humanixtechlab/EyeLink-Wheelchair/docs/images/tx-glasses-front.jpg.jpg

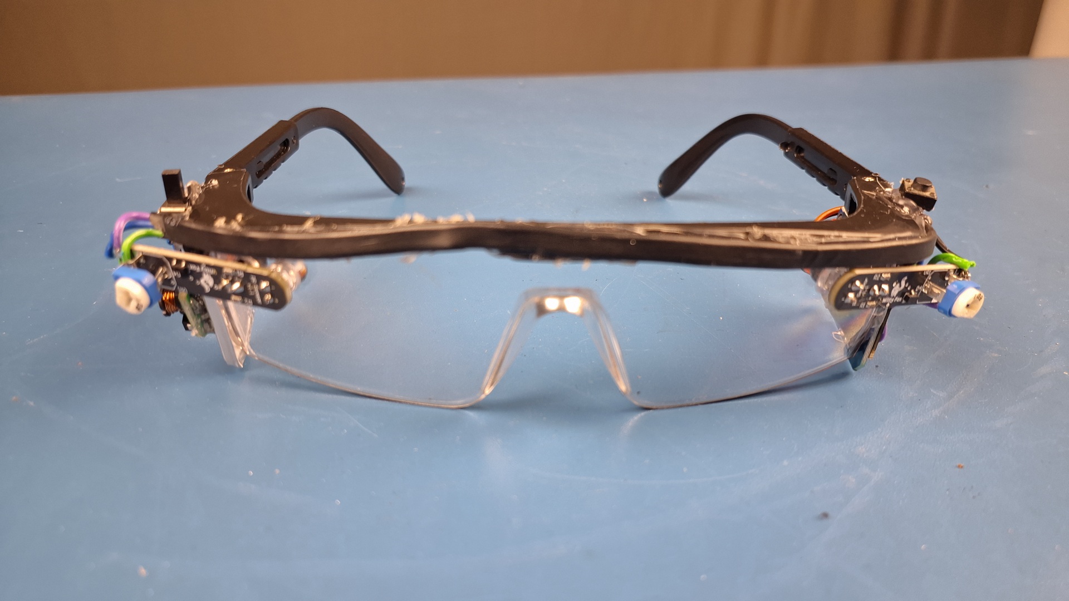
docs/images/tx-glasses-front.jpg.jpg
