humanixtechlab/EyeLink-Wheelchair/docs/images/tx-glasses.jpg.jpg

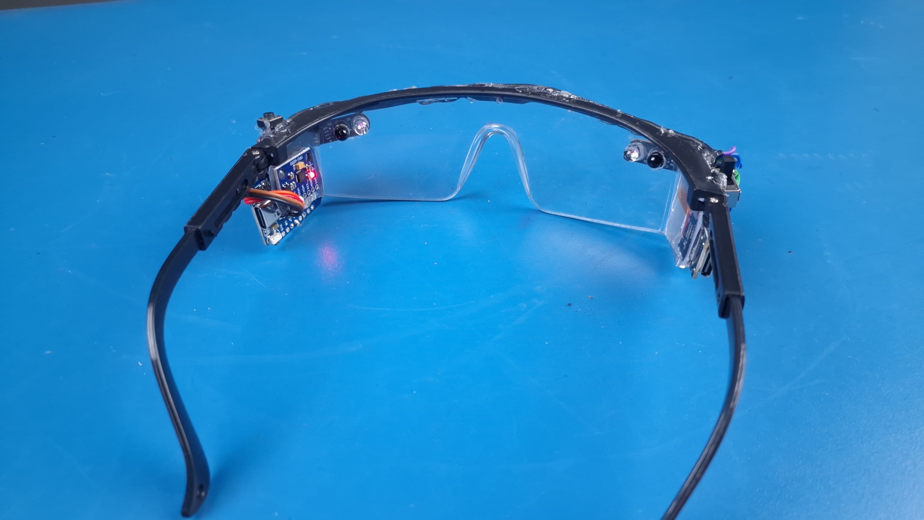
docs/images/tx-glasses.jpg.jpg
