humanixtechlab/EyeLink-Wheelchair/docs/images/wheelchair-front.jpg.jpg

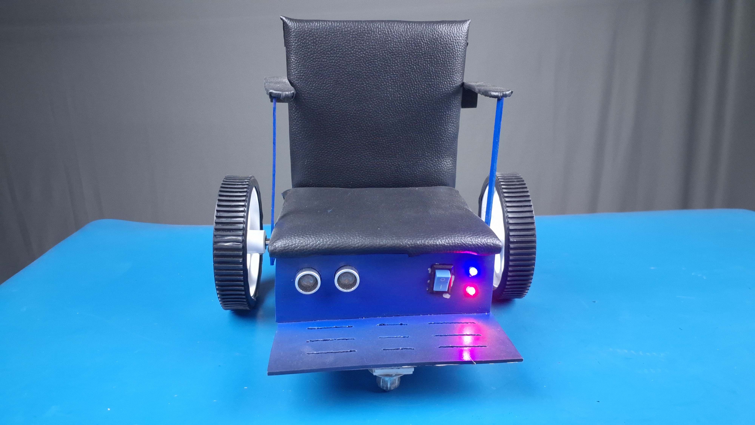
docs/images/wheelchair-front.jpg.jpg
