humanixtechlab/EyeLink-Wheelchair/docs/images/rx_build/rx_07_final.jpg.jpg

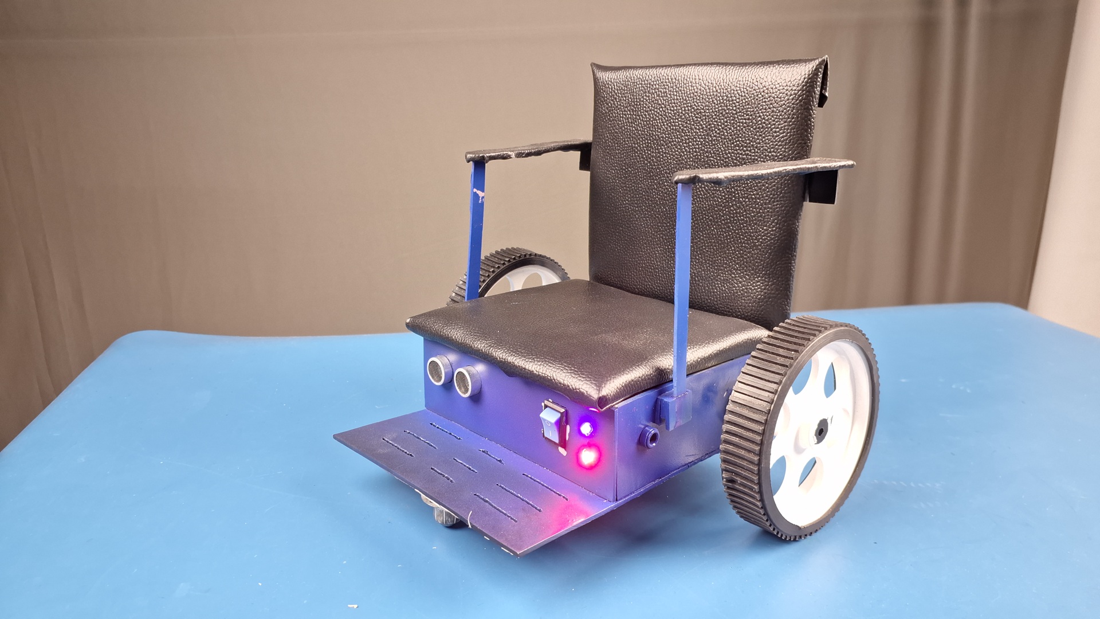
docs/images/rx_build/rx_07_final.jpg.jpg
