humanixtechlab/EyeLink-Wheelchair/docs/images/tx_build/tx_02_ir_sensors.jpg.jpg

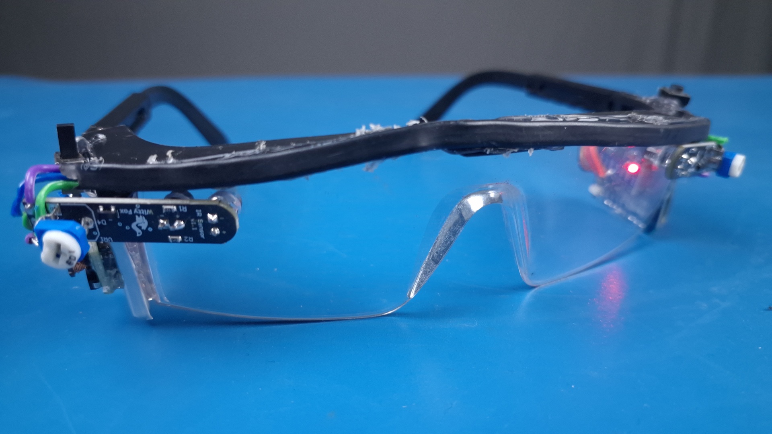
docs/images/tx_build/tx_02_ir_sensors.jpg.jpg
