humanixtechlab/EyeLink-Wheelchair/(commit log)

2026-06-21 images
    circuit images added
2026-06-21 circuit edited
    image changed
